vdcuong2002/DigitalSystemDesign/README.md

# DigitalSystemDesign
my Subject project
