vdcuong2002/DigitalSystemDesign/(list of files, drawings)

Other design files:
add_tro_PCB_congbit.PcbDoc
all.SchDoc
MachPrj.pdsprj
PCB_ALL.PrjPCB
pcball.PcbDoc
